NdreasNdersson/PicoW-Plant-Moisture-Sensor/README.md

# Install pre-commit
```
pip install pre-commit
pre-commit install
```

# Build
Following script will build the bootloader and rest sensor board application and combine these as a .bin file. It will
also prepend hash to application so it will be launched by the bootloader.
```
./build_and_combine.sh
```

# Flash first time
Connect Pico Probe and run ./flash_combined.sh

This will flash bootloader, default app info/storage and app.

# Config
Enter wifi SSID and password over serial when promted. Once it have connected, the sensors can be configured with REST API.
```
POST /SENSORS HTTP/1.1
Host: 192.168.X.X
Content-Type: application/json
Content-Length: 147

{"config":[{"calibrate_max_value":false,"calibrate_min_value":false,"inversed":true,"max":17736,"min":8266,"pin":1,"type":"moisture"},{"calibrate_max_value":false,"calibrate_min_value":true,"inversed":true,"max":16509,"min":1,"pin":2,"type":"moisture"}]}
```

# Rest get
Get sensor readings:
```
GET /SENSORS HTTP/1.1
Host: 192.168.50.205
```

Get current sensor config:
```
GET /CONFIG HTTP/1.1
Host: 192.168.50.205
```

# SW download
Run
```
./python/upload_new_binary.py --host 192.168.X.X --app-file build/ninja-release/PICO_REST_SENSOR_STRIPPED.bin
```

# Raspberry Pi Pico W Analog sensor board
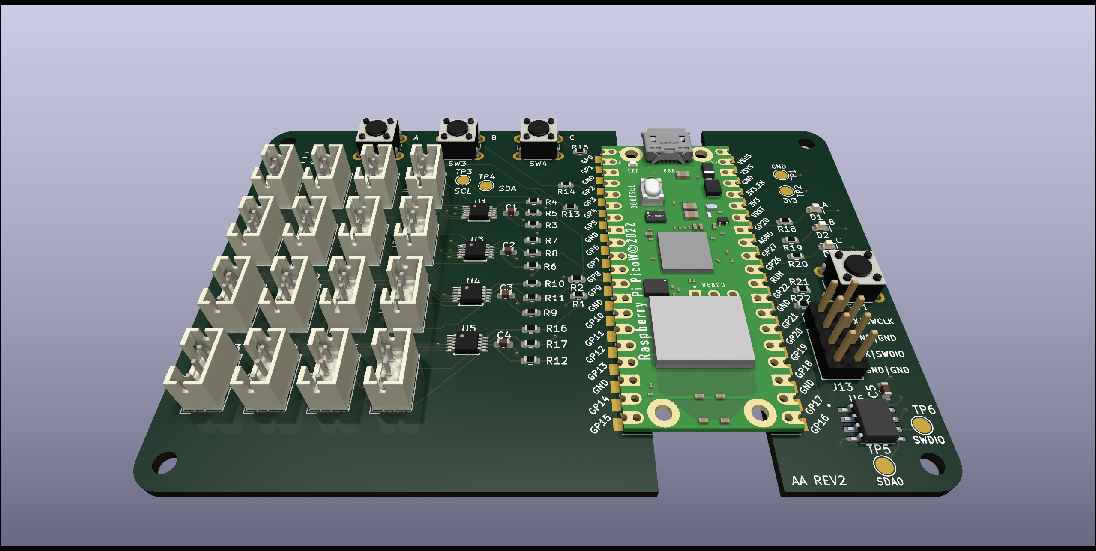
[picture p1: KiCad/picow_plant_moisture_sensor/picow_plant_moisture_sensor.png]
picow_plant_moisture_sensor
