NdreasNdersson/PicoW-Plant-Moisture-Sensor/KiCad/picow_plant_moisture_sensor/24LC16B-I_SN/24LC16B-I_SN.step

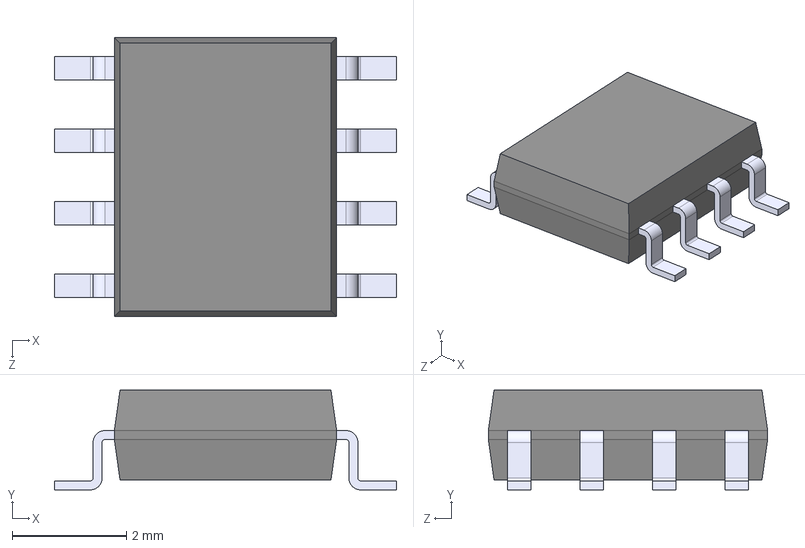
[picture p2: CAD file, 2024-03-02]
KiCad/picow_plant_moisture_sensor/24LC16B-I_SN/24LC16B-I_SN.step
6.00 x 1.75 x 4.90 mm
