NdreasNdersson/PicoW-Plant-Moisture-Sensor/(threads)

Thread 16 (2024-02-18):

Disable other core when writing to flash

NdreasNdersson, 2024-02-18:

NdreasNdersson, 2024-03-03:
https://www.raspberrypi.com/documentation/pico-sdk/high_level.html#:~:text=successful%2C%20false%20otherwise-,pico_flash,-Part%20of%3A

Closed 2024-03-11.

Thread 27 (2024-02-25):

Fix first incorrect adc sample

NdreasNdersson, 2024-02-25:

Closed 2024-04-04.

Thread 60 (2024-04-18):

Crashing after one day

NdreasNdersson, 2024-04-18:

NdreasNdersson, 2024-09-05:
Could be related to this assertion:
assertion "( uxCriticalNestings[ get_core_num() ] ) == 0"

Could be related to printing

Closed 2025-01-25.
