NdreasNdersson/PicoW-Plant-Moisture-Sensor/KiCad/picow_plant_moisture_sensor/picow_plant_moisture_sensor.kicad_pcb

## KiCad design KiCad/picow_plant_moisture_sensor/picow_plant_moisture_sensor.kicad_pcb (2024-03-03)

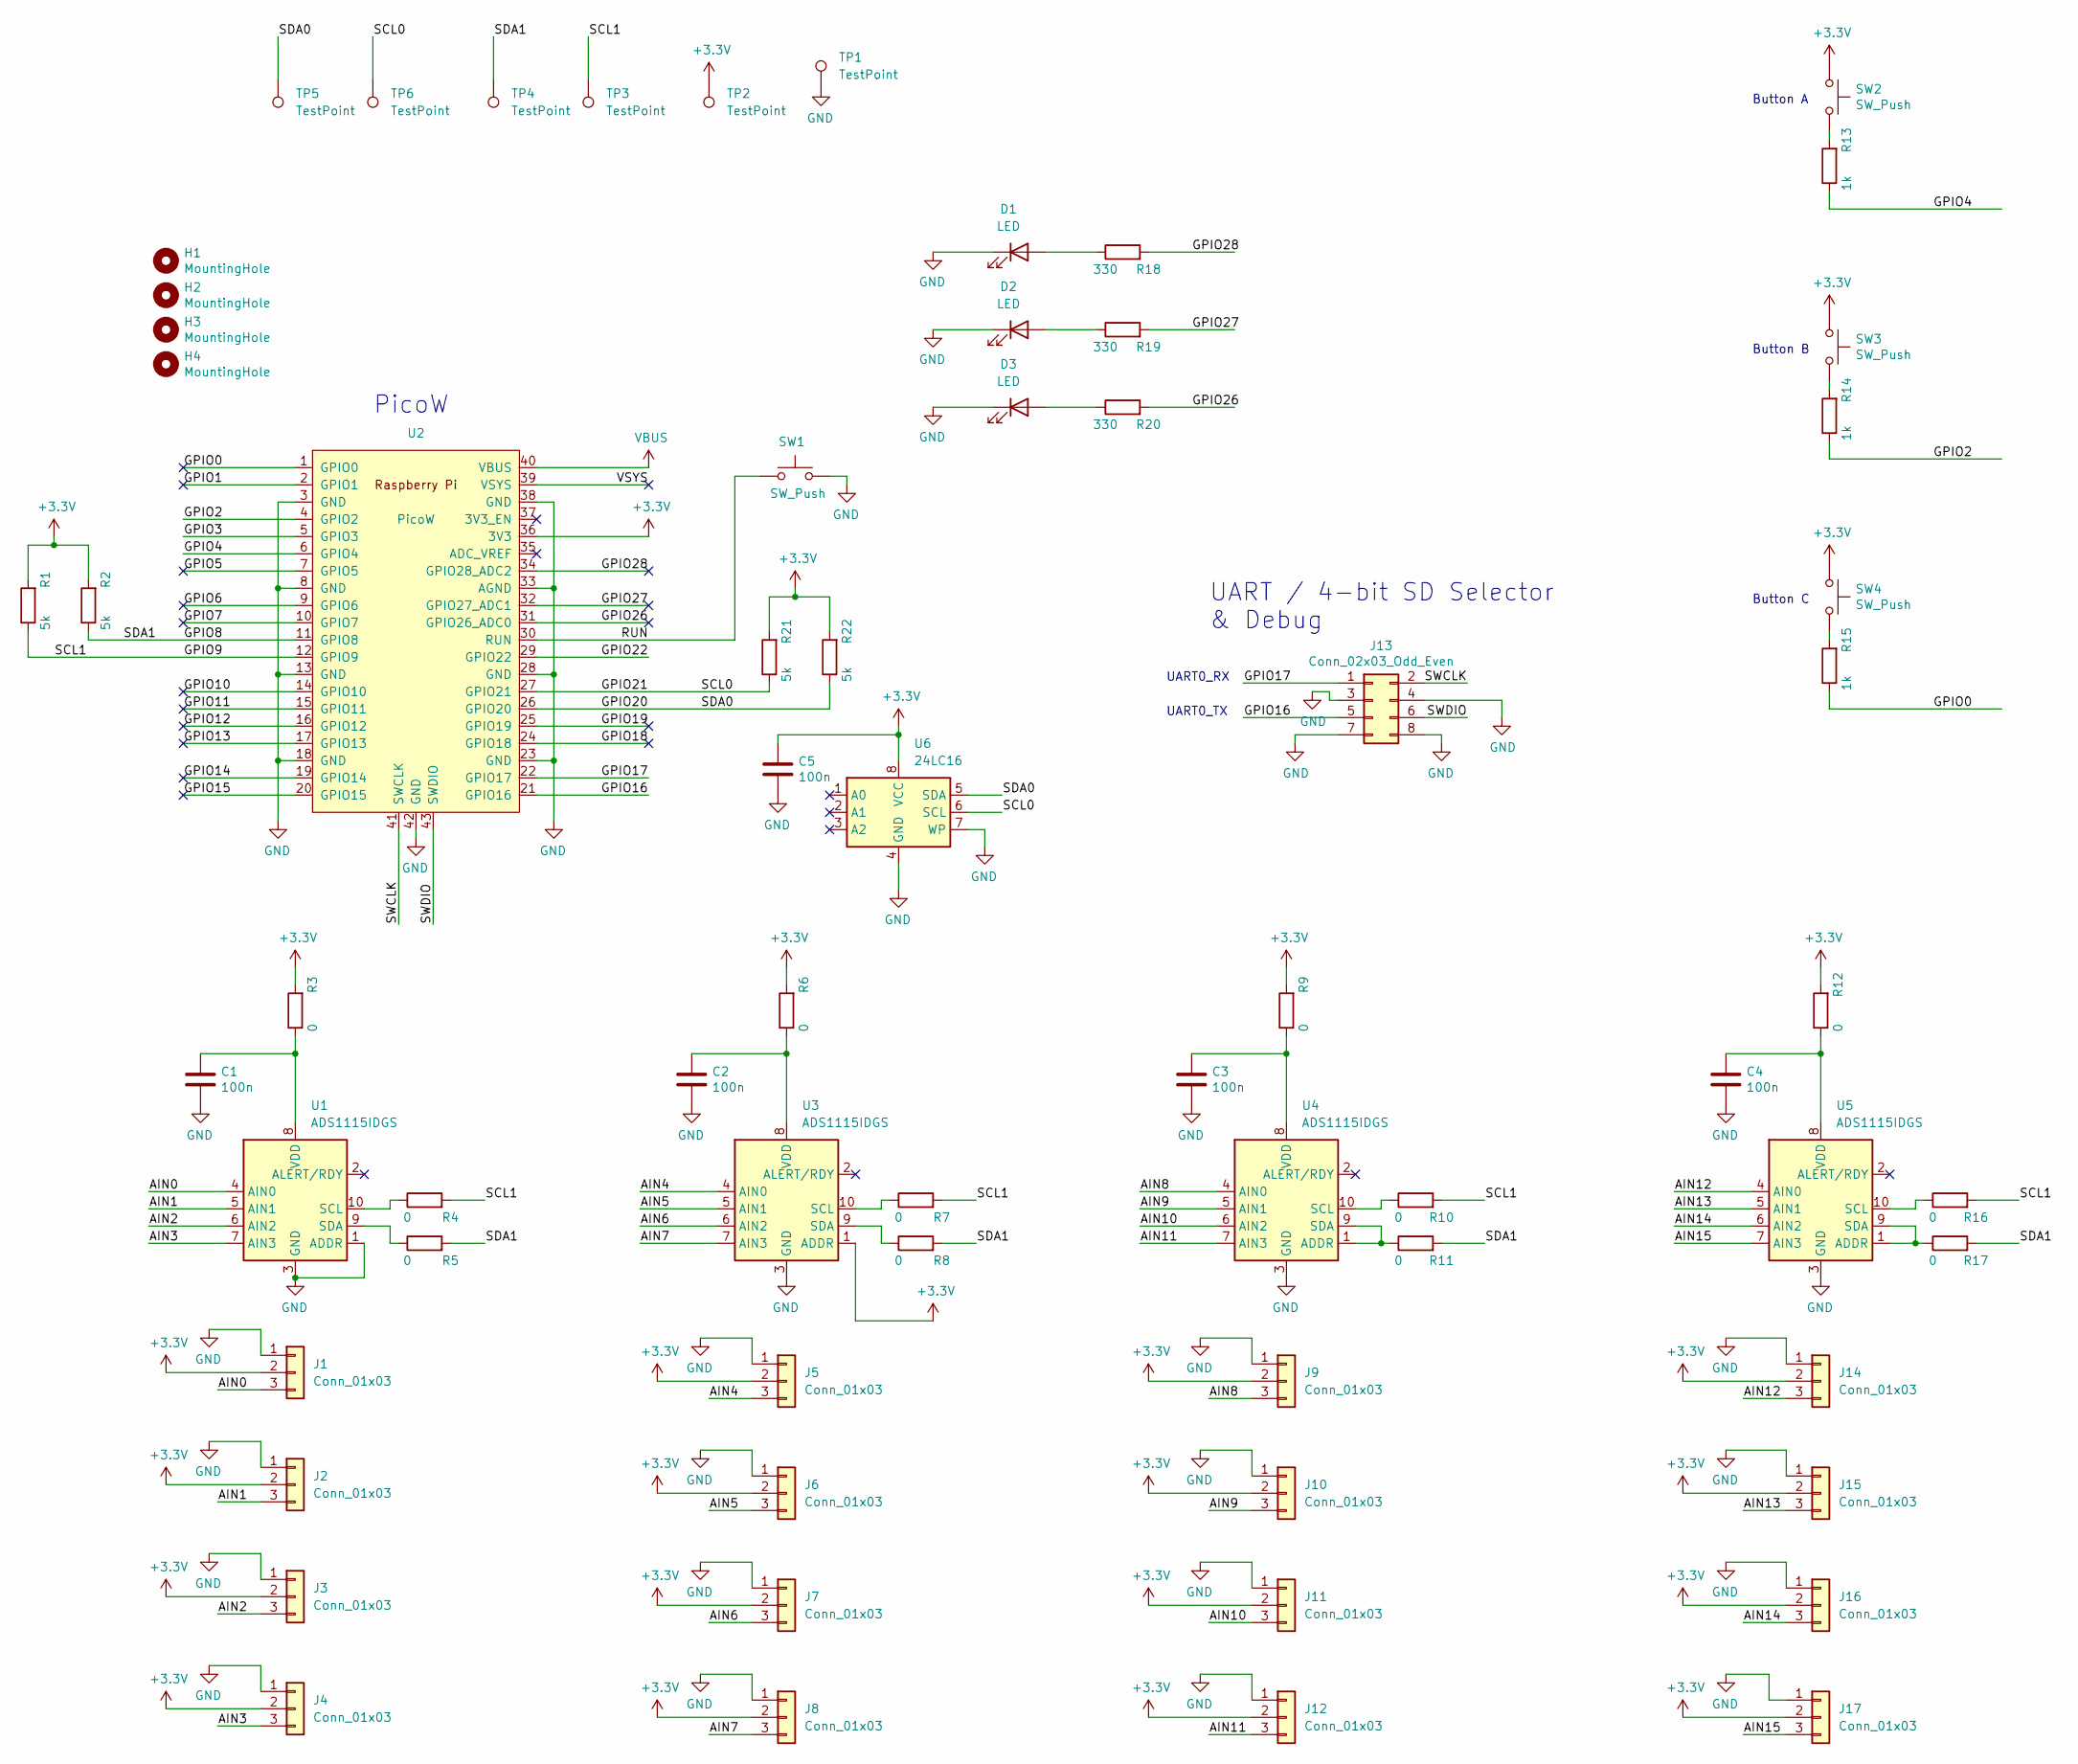
[picture p3: schematic picow_plant_moisture_sensor.kicad_sch, Analog Sensor Board for Pico W]

Parts:
C1, C2, C3, C4, C5: 100n; C_0603_1608Metric; LCSC C1525
D1, D2, D3: LED; LED_0603_1608Metric; LCSC C2290
H1, H2, H3, H4: MountingHole; MountingHole_2.7mm_M2.5
J1, J2, J3, J4, J5, J6, J7, J8, J9, J10, J11, J12, J14, J15, J16, J17: Conn_01x03; JST_PH_B3B-PH-K_1x03_P2.00mm_Vertical
J13: Conn_02x03_Odd_Even; PinHeader_2x04_P2.54mm_Vertical
R1, R2, R21, R22: 5k; R_0603_1608Metric; LCSC C25900
R3, R4, R5, R6, R7, R8, R9, R10, R11, R12, R16, R17: 0; R_0603_1608Metric; LCSC C21189
R13, R14, R15: 1k; R_0603_1608Metric; LCSC C11702
R18, R19, R20: 330; R_0603_1608Metric; LCSC C25104
SW1, SW2, SW3, SW4: SW_Push; SW_PUSH_6mm
TP1, TP2, TP3, TP4, TP5, TP6: TestPoint; TestPoint_Pad_D2.0mm
U1, U3, U4, U5: ADS1115IDGS; TSSOP-10_3x3mm_P0.5mm; LCSC C37593
U2: PicoW; RPi_PicoW_SMD_TH
U6: 24LC16; SOIC127P600X175-8N

Connections:
+3V3: C5.1, J1.2, J2.2, J3.2, J4.2, J5.2, J6.2, J7.2, J8.2, J9.2, J10.2, J11.2, J12.2, J14.2, J15.2, J16.2, J17.2, R1.2, R2.2, R3.2, R6.2, R9.2, R12.2, R21.2, R22.2, SW2.1, SW3.1, SW4.1, TP2.1, U2.36 (3V3), U3.1 (ADDR), U6.8 (VCC)
/AIN0: J1.3, U1.4 (AIN0)
/AIN1: J2.3, U1.5 (AIN1)
/AIN2: J3.3, U1.6 (AIN2)
/AIN3: J4.3, U1.7 (AIN3)
/AIN4: J5.3, U3.4 (AIN0)
/AIN5: J6.3, U3.5 (AIN1)
/AIN6: J7.3, U3.6 (AIN2)
/AIN7: J8.3, U3.7 (AIN3)
/AIN8: J9.3, U4.4 (AIN0)
/AIN9: J10.3, U4.5 (AIN1)
/AIN10: J11.3, U4.6 (AIN2)
/AIN11: J12.3, U4.7 (AIN3)
/AIN12: J14.3, U5.4 (AIN0)
/AIN13: J15.3, U5.5 (AIN1)
/AIN14: J16.3, U5.6 (AIN2)
/AIN15: J17.3, U5.7 (AIN3)
/GPIO0: R15.1, U2.1 (GPIO0)
/GPIO1: U2.2 (GPIO1)
/GPIO2: R14.1, U2.4 (GPIO2)
/GPIO3: U2.5 (GPIO3)
/GPIO4: R13.1, U2.6 (GPIO4)
/GPIO5: U2.7 (GPIO5)
/GPIO6: U2.9 (GPIO6)
/GPIO7: U2.10 (GPIO7)
/GPIO8: R2.1, R5.2, R8.2, R11.2, R17.2, TP4.1, U2.11 (GPIO8)
/GPIO9: R1.1, R4.2, R7.2, R10.2, R16.2, TP3.1, U2.12 (GPIO9)
/GPIO10: U2.14 (GPIO10)
/GPIO11: U2.15 (GPIO11)
/GPIO12: U2.16 (GPIO12)
/GPIO13: U2.17 (GPIO13)
/GPIO14: U2.19 (GPIO14)
/GPIO15: U2.20 (GPIO15)
/GPIO16: J13.5, U2.21 (GPIO16)
/GPIO17: J13.1, U2.22 (GPIO17)
/GPIO18: U2.24 (GPIO18)
/GPIO19: U2.25 (GPIO19)
/GPIO20: R22.1, TP5.1, U2.26 (GPIO20), U6.5 (SDA)
/GPIO21: R21.1, TP6.1, U2.27 (GPIO21), U6.6 (SCL)
/GPIO22: U2.29 (GPIO22)
/GPIO26: R20.2, U2.31 (GPIO26_ADC0)
/GPIO27: R19.2, U2.32 (GPIO27_ADC1)
/GPIO28: R18.2, U2.34 (GPIO28_ADC2)
/RUN: SW1.1, U2.30 (RUN)
/SWCLK: J13.2, U2.41 (SWCLK)
/SWDIO: J13.6, U2.43 (SWDIO)
/VSYS: U2.39 (VSYS)
GND: C1.2, C2.2, C3.2, C4.2, C5.2, D1.1 (K), D2.1 (K), D3.1 (K), J1.1, J2.1, J3.1, J4.1, J5.1, J6.1, J7.1, J8.1, J9.1, J10.1, J11.1, J12.1, J13.3, J13.4, J13.7, J13.8, J14.1, J15.1, J16.1, J17.1, SW1.2, TP1.1, U1.1 (ADDR), U1.3 (GND), U2.3 (GND), U2.8 (GND), U2.13 (GND), U2.18 (GND), U2.23 (GND), U2.28 (GND), U2.33 (AGND), U2.38 (GND), U2.42 (GND), U3.3 (GND), U4.3 (GND), U5.3 (GND), U6.4 (GND), U6.7 (WP)
unnamed: D1.2 (A), R18.1
unnamed: D2.2 (A), R19.1
unnamed: D3.2 (A), R20.1
unnamed: R13.2, SW2.2
unnamed: R14.2, SW3.2
unnamed: R15.2, SW4.2
unnamed: R4.1, U1.10 (SCL)
unnamed: R5.1, U1.9 (SDA)
unnamed: C1.1, R3.1, U1.8 (VDD)
unnamed: R7.1, U3.10 (SCL)
unnamed: R8.1, U3.9 (SDA)
unnamed: C2.1, R6.1, U3.8 (VDD)
unnamed: R11.1, U4.1 (ADDR), U4.9 (SDA)
unnamed: R10.1, U4.10 (SCL)
unnamed: C3.1, R9.1, U4.8 (VDD)
unnamed: R17.1, U5.1 (ADDR), U5.9 (SDA)
unnamed: R16.1, U5.10 (SCL)
unnamed: C4.1, R12.1, U5.8 (VDD)
VBUS: U2.40 (VBUS)

Notes on the sheet:
Button A
UART0_TX
PicoW
UART0_RX
Button B
Button C
UART / 4-bit SD Selector & Debug

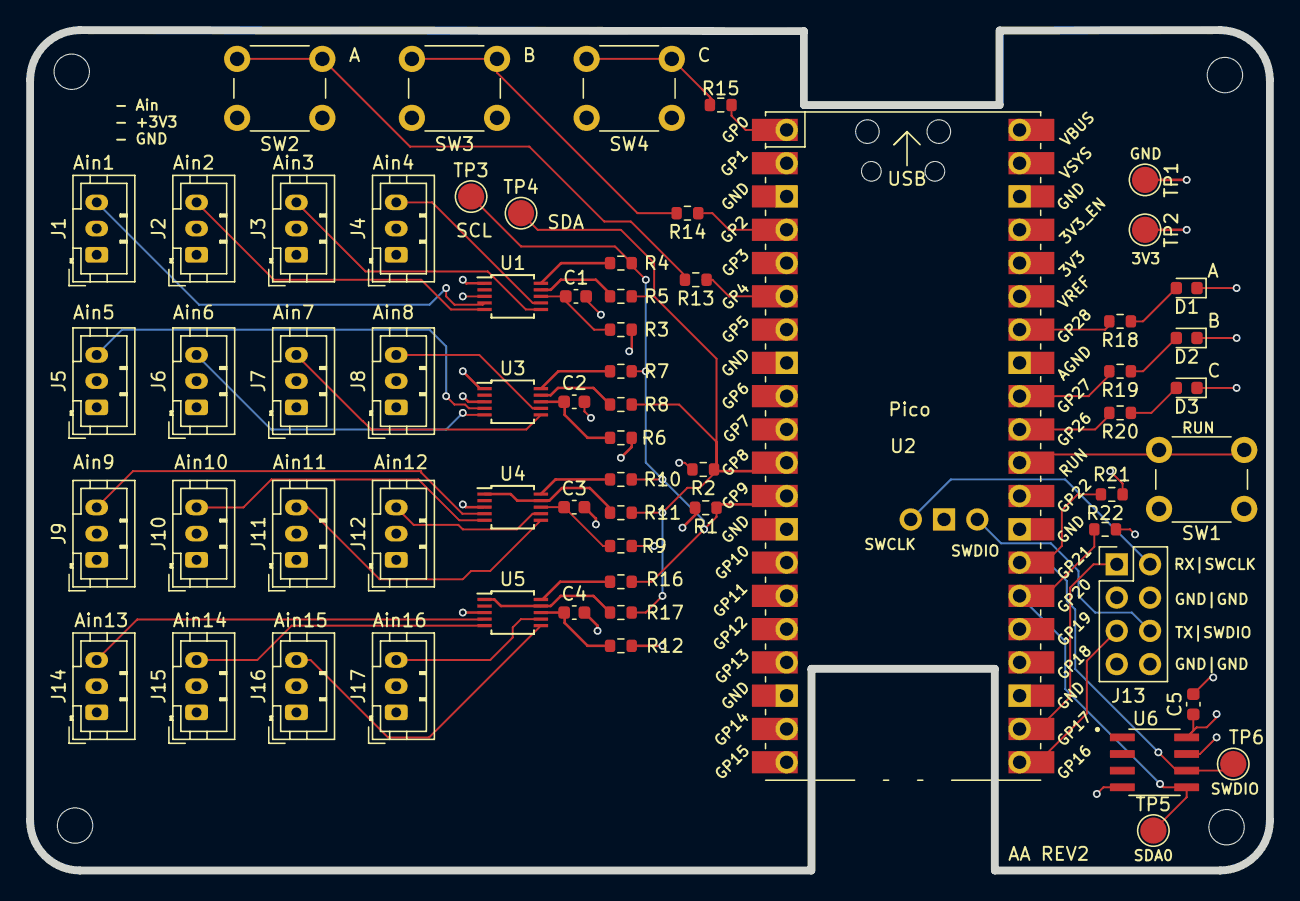
[picture p4: board picow_plant_moisture_sensor.kicad_pcb from above]

Board: 4 copper layers, 94.6 x 64.1 mm, 67 parts (0 on the bottom side), 51 nets.
