NdreasNdersson/PicoW-Plant-Moisture-Sensor/src/sensors/sensor_factory.cpp

#include "sensor_factory.h"

#include <functional>
#include <limits>

#include "hardware/gpio.h"
#include "hardware/i2c.h"
#include "sensors/ads1115_adc.h"
#include "sensors/temp_adc.h"
#include "utils/button/button_control.h"
#include "utils/config_handler/configs/sensor_config.h"
#include "utils/logging.h"

void SensorFactory::create(std::vector<sensor_config_t> &pin_configs,
                           std::vector<std::shared_ptr<Sensor>> &sensors,
                           ButtonControl &button_control,
                           const std::function<void(bool)> &led_callback,
                           float delta_time) {
    if (pin_configs.empty() || (m_number_of_dacs > MAX_NUMBER_OF_DACS)) {
        LogError(("Can't initialise %u dacs", m_number_of_dacs));
    } else {
        i2c_init(I2C_PORT, I2C_FREQ);
        gpio_set_function(SDA_PIN, GPIO_FUNC_I2C);
        gpio_set_function(SCL_PIN, GPIO_FUNC_I2C);

        sensors.reserve(pin_configs.size());

        for (auto &config : pin_configs) {
            if (config.pin < 1) {
                LogError(("Pin number can't be less than 1"));
                continue;
            }
            auto dac_idx{static_cast<uint8_t>((config.pin - 1U) /
                                              MAX_NUMBER_OF_ANALOG_PINS)};
            auto dac_id{dac_idx + 1U};
            auto analog_pin_id{(config.pin - 1) % MAX_NUMBER_OF_ANALOG_PINS +
                               1};

            if (dac_id > m_number_of_dacs) {
                LogError(("DAC %u are not in use", dac_id));
                continue;
            }

            if ((config.max_value - config.min_value) == 0) {
                config.min_value = std::numeric_limits<std::uint16_t>::min();
                config.max_value = std::numeric_limits<std::uint16_t>::max();
            }

            auto sensor{std::make_shared<Ads1115Adc>(config, button_control,
                                                     led_callback, delta_time)};
            switch (analog_pin_id) {
                case 1:
                    sensor->init(I2C_PORT, ADS1115_I2C_FIRST_ADDRESS + dac_idx,
                                 ADS1115_MUX_SINGLE_0);
                    break;
                case 2:
                    sensor->init(I2C_PORT, ADS1115_I2C_FIRST_ADDRESS + dac_idx,
                                 ADS1115_MUX_SINGLE_1);
                    break;
                case 3:
                    sensor->init(I2C_PORT, ADS1115_I2C_FIRST_ADDRESS + dac_idx,
                                 ADS1115_MUX_SINGLE_2);
                    break;
                case 4:
                    sensor->init(I2C_PORT, ADS1115_I2C_FIRST_ADDRESS + dac_idx,
                                 ADS1115_MUX_SINGLE_3);
                    break;
                default:
                    break;
            }

            LogDebug(
                ("Init ADS1115: %d analog pin: %d", dac_id, analog_pin_id));
            sensors.push_back(sensor);
        }
    }

    sensor_config_t config{};
    config.type = "internal_temperature";
    auto sensor{std::make_shared<TempAdc>(config, led_callback)};
    sensor->init();
    sensors.push_back(sensor);
}
