NdreasNdersson/PicoW-Plant-Moisture-Sensor/src/sensors/ads1115_adc.h

#ifndef PICO_REST_SENSOR_SENSORS_ADS1115_ADC_H_
#define PICO_REST_SENSOR_SENSORS_ADS1115_ADC_H_

#include <cstdint>
#include <functional>
#include <list>
#include <string>

#include "ads1115.h"
#include "hardware/i2c.h"
#include "patterns/subscriber.h"
#include "registers.h"
#include "sensors/sensor.h"
#include "utils/button/button_control.h"
#include "utils/config_handler/configs/sensor_config.h"
#include "utils/low_pass_filter.h"

class Ads1115Adc : public Sensor {
   public:
    Ads1115Adc(sensor_config_t &config, ButtonControl &button_control,
               std::function<void(bool)> led_callback, float delta_time);
    ~Ads1115Adc() = default;
    Ads1115Adc(const Ads1115Adc &) = delete;
    Ads1115Adc(Ads1115Adc &&) = delete;
    Ads1115Adc &operator=(const Ads1115Adc &) = delete;
    Ads1115Adc &operator=(Ads1115Adc &&) = delete;

    void init(i2c_inst_t *i2c, uint8_t address,
              const ads1115_mux_t mux_setting);
    auto read(sensor_config_t &config) -> SensorReadStatus override;

    // Publisher
    void attach(Subscriber<Measurement_t> *subscriber) override;
    void detach(Subscriber<Measurement_t> *subscriber) override;
    void notify(const Measurement_t &) override;

   private:
    static constexpr int SAMPLES_TO_COMPLETE_CALIBRATION{100};
    struct ads1115_adc adc_state_;
    sensor_config_t config_;
    int calibration_samples_;
    std::string name_;
    std::function<void(bool)> led_callback_;
    LowPassFilter<float> low_pass_filter_;
    std::list<Subscriber<Measurement_t> *> list_subscribers_;
    ButtonControl &button_control_;
};

#endif  // PICO_REST_SENSOR_SENSORS_ADS1115_ADC_H_
