NdreasNdersson/PicoW-Plant-Moisture-Sensor/(commit log)

2024-02-07 Rest api (#2)
    * Restructure files into folders
    * Remove TwinThingPicoW include
    * Logging with FreeRTOS log interface
    * Hangs at MQTT_Connect:2710
    * Update MQTT config
    * Clean up of things no longer necessary
    * TCP working with one buffer to send
    * REST sensor working
    * Sending data works
    [main.cpp]
2024-02-09 Update formatting (#8)
    * Add ads1115 submodule
    * Reading sensor works
    * Indent 4
    * Add workflow to run pre-commit
    * Add more checks and exclude configs folder
    * Fix failing files
    [main.cpp]
2024-02-10 Add pcb design (#9)
    * Add project based on PicoW example
    * .gitignore
    * Set address on sda1115 devices
    * First version done
    * V1 done
    [picow_plant_moisture_sensor.kicad_pcb, picow_plant_moisture_sensor.kicad_sch]
2024-02-13 10 pcb design with ics instead of complete pcb on headers (#11)
    * No traces
    * Routing done
    * Complete PCB design with component references
    * Rev1 ordered
    [picow_plant_moisture_sensor.kicad_pcb, picow_plant_moisture_sensor.kicad_sch]
2024-02-16 5 add moisture sensor (#12)
    * Fix compilation warning
    * Added skeleton of sensors
    * Variable number of sensors can be constructed
    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
    [ads1115_adc.cpp, ads1115_adc.h, main.cpp, sensor_factory.cpp, sensor_factory.h]
2024-02-18 7 config for secrets instead of included in binary (#17)
    * Json can be parsed
    * Use debug logging when build for debug
    * Write and read from flash works
    * A bit of clean up
    * Back from .env, abs path not working
    * Remove creds files
    [main.cpp]
2024-02-19 3 queded logging (#25)
    * Add proper close of main task and report on LED
    * Logging uses queue
    * Use logger in tcp_server
2024-02-24 Led Control added (#26)
2024-02-26 21 store sensor calibrations in flash (#29)
    * Calibration routine added
    * Calibration can be set in factory
    * Some clean up
    * Change json module and construct sensors based on flash config
    * Fix includes
    [ads1115_adc.cpp, ads1115_adc.h, main.cpp, sensor_factory.cpp, sensor_factory.h]
2024-03-02 Add rev2 (#33)
    [24LC16B-I_SN.step, picow_plant_moisture_sensor.kicad_pcb, picow_plant_moisture_sensor.kicad_sch]
2024-03-03 32 board bring up (#35)
    * Add rev2
    * Add eeprom cap and I2C test points
    [picow_plant_moisture_sensor.kicad_pcb, picow_plant_moisture_sensor.kicad_sch]
2024-03-03 32 board bring up (#36)
    * Exclude KiCad folder from pre-commit
    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
2024-03-11 16 disable other core when writing to flash (#40)
    * Change name
    * Implement safe write to flash
    * Run pre-commit
    * Fix wrong name
    * Check flash_safe_execute return status
    [main.cpp]
2024-04-01 Allow partial config update (#46)
    * Allow partial config update
    * Handle dac out of range
    * Turn led b on when client is connected
    * Do not force flash
    * Removed unused sent callback
2024-04-04 49 fix long string in flash not parsed properly (#50)
    * Remove print that overflow the print buffer
    * Add .clangd file
2024-04-04 27 fix first incorrect adc sample (#51)
    * Add delay to allow conversion to complete before reading
    * Remove old ads1115 repo
    [sensor_factory.cpp]
2024-04-06 Button control added as publisher (#52)
    * Button control added as publisher
    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
    [button.cpp, button.h, button_control.cpp, button_control.h, main.cpp]
2024-04-07 47 trigger sensor calibration with button (#53)
    * Calibration started from button press
    * Remove callbacks and return sensor instances instead
    * Update logging
    * Save calibrated values to flash
    * Show readings and calibration on led A
2024-04-12 54 send both calculated and raw value (#55)
    * Raw value sent
    * Add low pass filter
2024-04-13 Change to filter for float (#58)
2024-04-18 18 add clang tidy (#59)
    * Add config and script to run
    * Fixed warnings in utils button/led and logging stack
    * Use default constructor and initialize all members
    * Auto fix all files
    * Add more checks
    [ads1115_adc.cpp, button.cpp, button.h, button_control.cpp, led.cpp, led.h, led_control.cpp]
2024-04-18 Clang tidy fixes (#62)
    * Fix clang-tidy suggestions
    * Clangtidy auto fix
    * Change struct names
    [ads1115_adc.h, main.cpp, sensor_factory.cpp]
2024-09-04 65 add bootloader an swdw (#66)
    * Add bootloader repo and integrate
    * Link bootloader lib and use correct flash storage area
    * Request wifi config over serial if already not saved
    * Send hash and app size to SWDW
    * Use more restrictive wildcards for artifacts
    * SWDL working
    * Auto format all files
    [main.cpp]
2024-09-06 Restart if sensor config was updated (#71)
2024-09-10 73 try codechecker (#74)
    * Remove run clang-tidy
    * CodeChecker auto fix
    * Fix static code analysis warnings
    * Remove __ from names and update include guards
    * Fix static code analysis warnings
    * Remove newline in logger
    * Upgrade FreeRTOS
    * Increase logger thread stack
    * Build release by default
    * Run static code analysis only on project files
    * Fix static code analysis warnings
    * Fix static code analysis warnings
    * Update bootloader lib
    [ads1115_adc.cpp, ads1115_adc.h, button.h, button_control.cpp, button_control.h]
2024-09-11 75 create generic sensor implementation (#76)
    * Use interface type Sensor
    * Add internal temperature as a sensor
2024-09-17 Use docker to build (#80)
    * Clean up files
    * Build with docker
    * Run docker command
    * Use pico-sdk and freertos kernel from env
    * Use docker for all github action commands
    * CodeChecker run without error
    * Fix code checker warnings
    * Fail only if parse fails, not on warnings
    * Fix static code analysis warning
    * Define app storage globally
    * Increase tcp stack size
    * Update .codechecker.json
    * Print c style string
    [ads1115_adc.h, lwipopts.h]
2024-09-17 Unsubscribe at destruction (#84)
    * Unsubscribe at destruction
    * Always initialize temp sensor
    * Fix static code analyzis warnings
    [ads1115_adc.cpp, ads1115_adc.h, main.cpp, sensor_factory.cpp, sensor_factory.h]
2024-09-18 85 add sensor subscription (#86)
    * Use payload for publisher and subscribers notify
    * Sensors use publisher api
    * Restructure get config content
    * Delete copy constructors and so on
    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
    [ads1115_adc.cpp, ads1115_adc.h, button.cpp, button.h, button_control.cpp, button_control.h, main.cpp]
2024-09-19 87 restore after swdl with button press (#88)
    * Move main code to its own class
    * Add callback to restore when button B is pressed
    * Instantiate button control later, otherwise interupts don't work
    * Start task after interupts
    * Update with newest bootloader
2024-09-26 Update to newest bootloader (#90)
    * Update to newest bootloader
    * Fix run unittests
    * Do not track compile_commands
    [plant_moisture_sensor.cpp, plant_moisture_sensor.h]
2025-01-20 99 remote start of calibration (#101)
    * Add calibration config
    * Trigger calibration from updated sensor config
    * Update readme
2025-01-21 94 add unittests (#95)
    * Add pico interface files
    * Add test for config handler
    * Align with changes for unittests
    * Run config handler init
    * Update bootloader
    * Add config handler interface and align pico bootloader namespace
    * Mock FreeRTOS and software download
    * Test get and post
    * Run coverage
    * Add test for new json structure
    ---------
2025-01-26 107 mqtt (#108)
    * Add MQTT client and config handling
    * Add REST MQTT post handler
    * Move all configs to config handler folder
    * Update tests
    * Fix test
    [ads1115_adc.cpp, ads1115_adc.h]
